vqxel/RezqMicromouse/Notes/MotionProfileLogic2-1.png

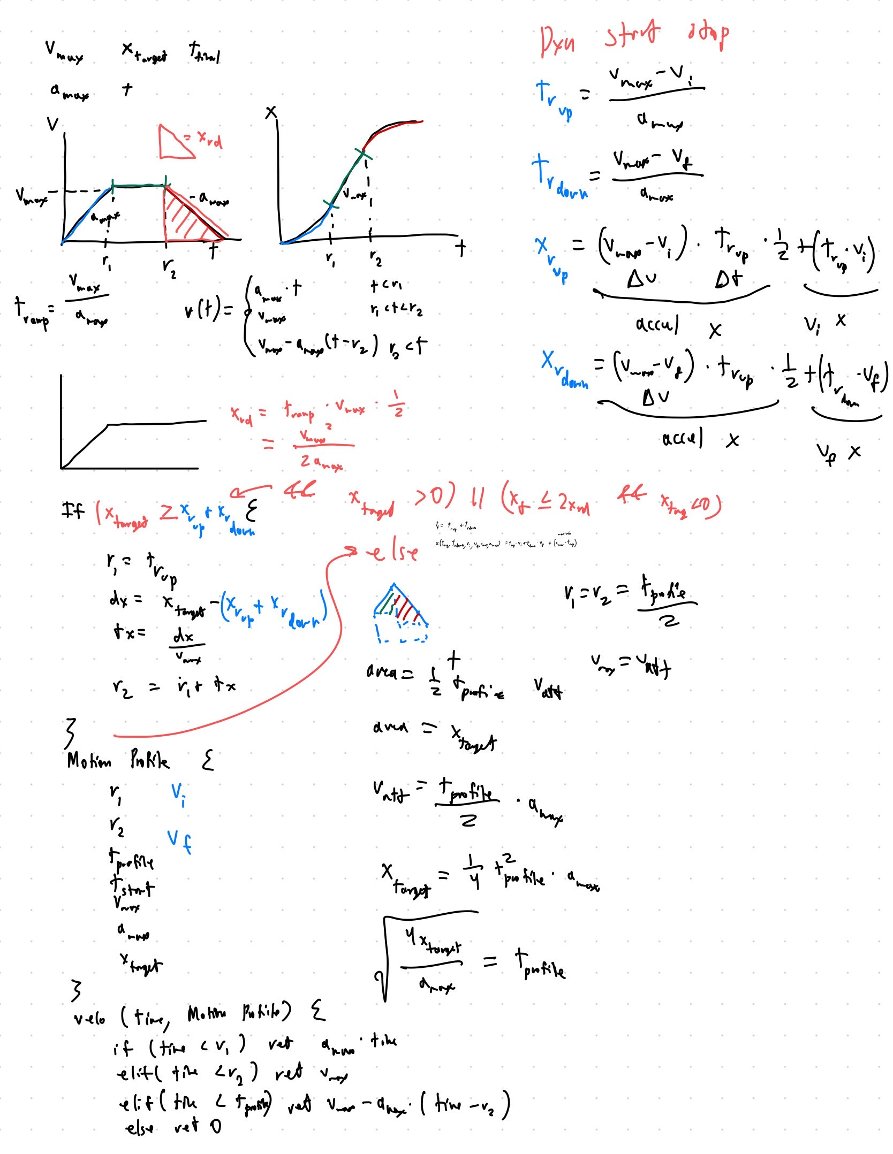
Notes/MotionProfileLogic2-1.png
