vqxel/RezqMicromouse/Notes/MotionProfileLogic2-2.png

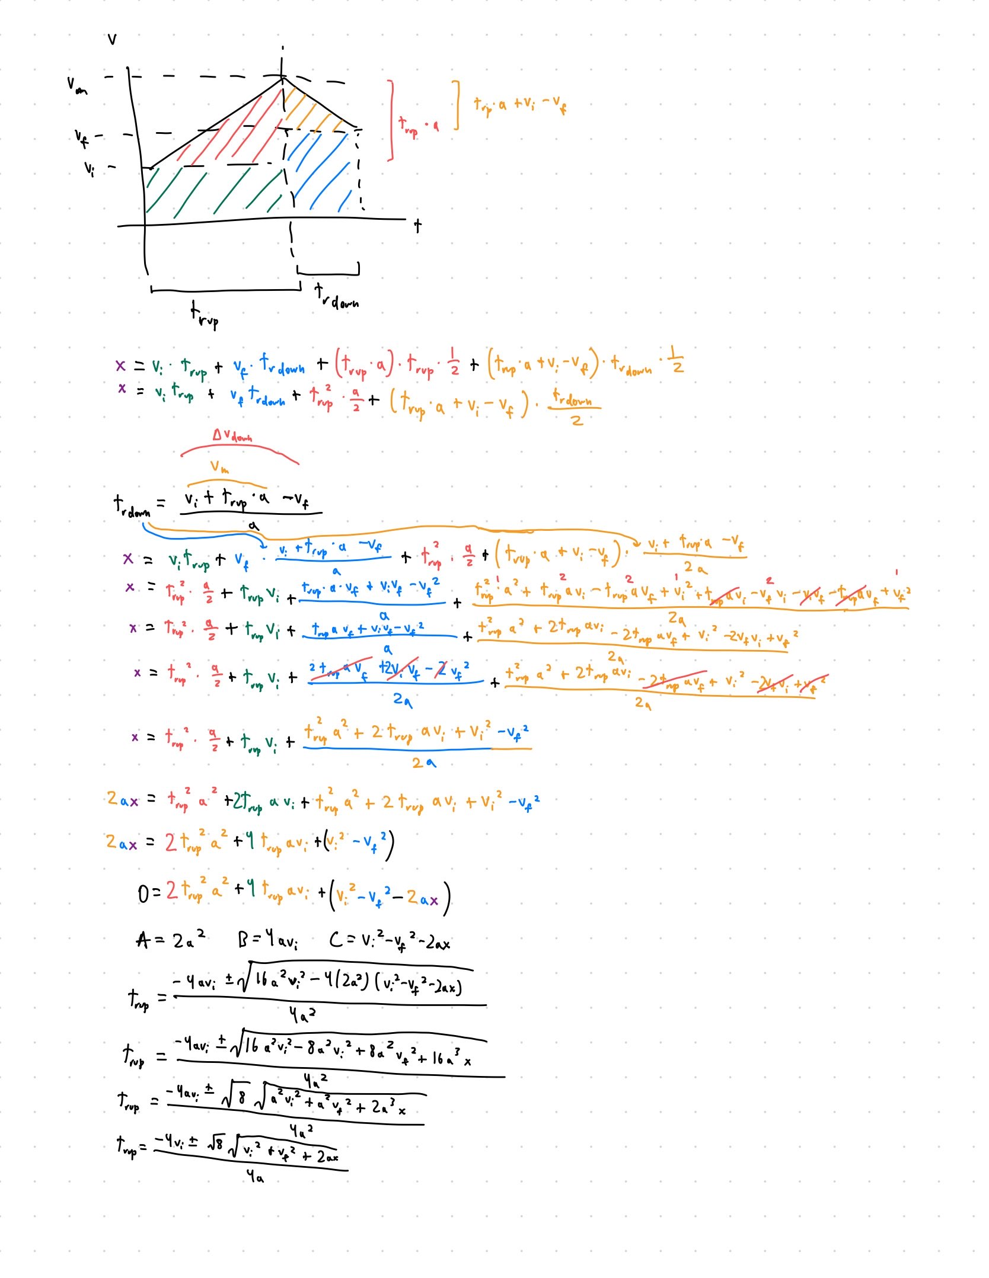
Notes/MotionProfileLogic2-2.png
