vqxel/RezqMicromouse/Notes/MotionProfileLogic.png

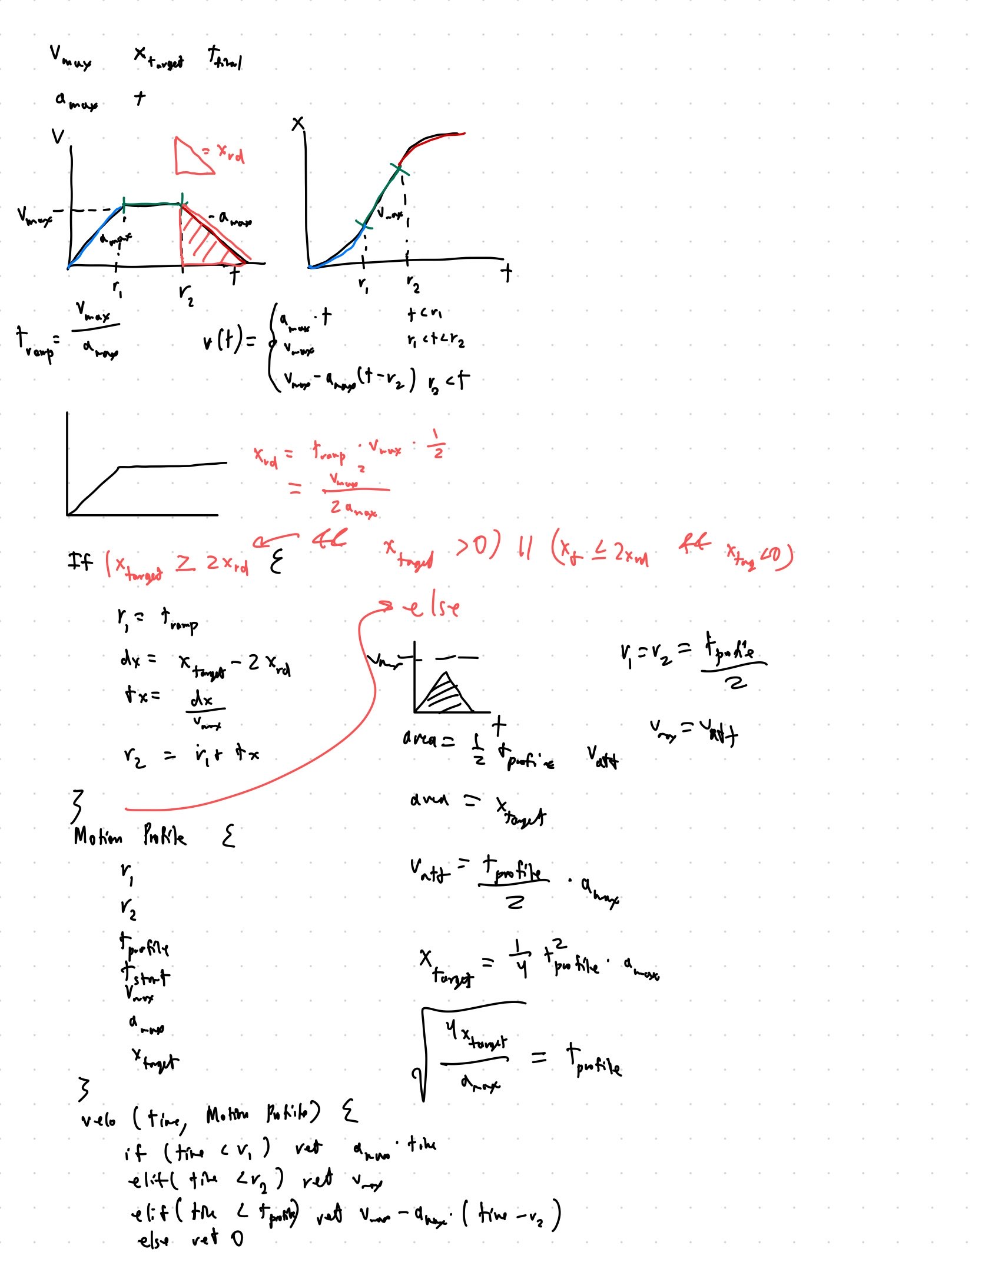
Notes/MotionProfileLogic.png
