vqxel/RezqMicromouse/Assets/VXL - ALTFX.dxf

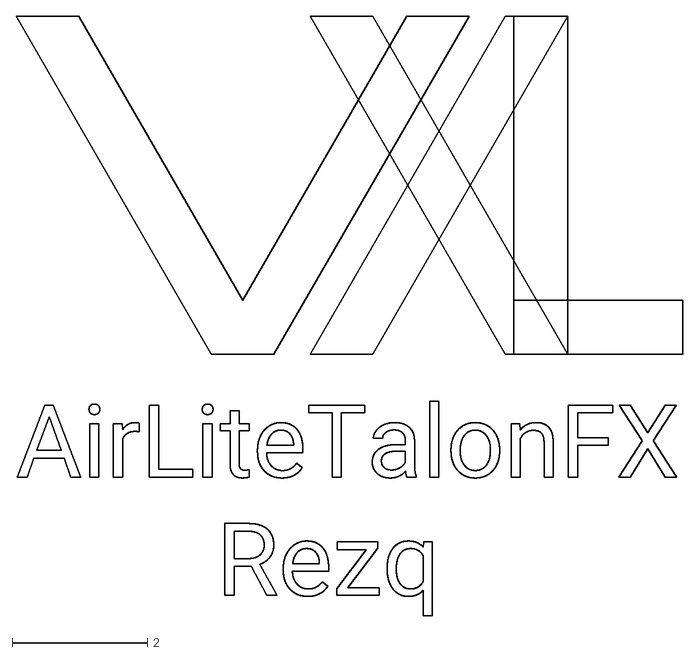
[picture p4: CAD file, 2024-12-14]
Assets/VXL - ALTFX.dxf
9.85 x 8.86
