vqxel/RezqMicromouse/EKFExperiments/ekf_test_result.png

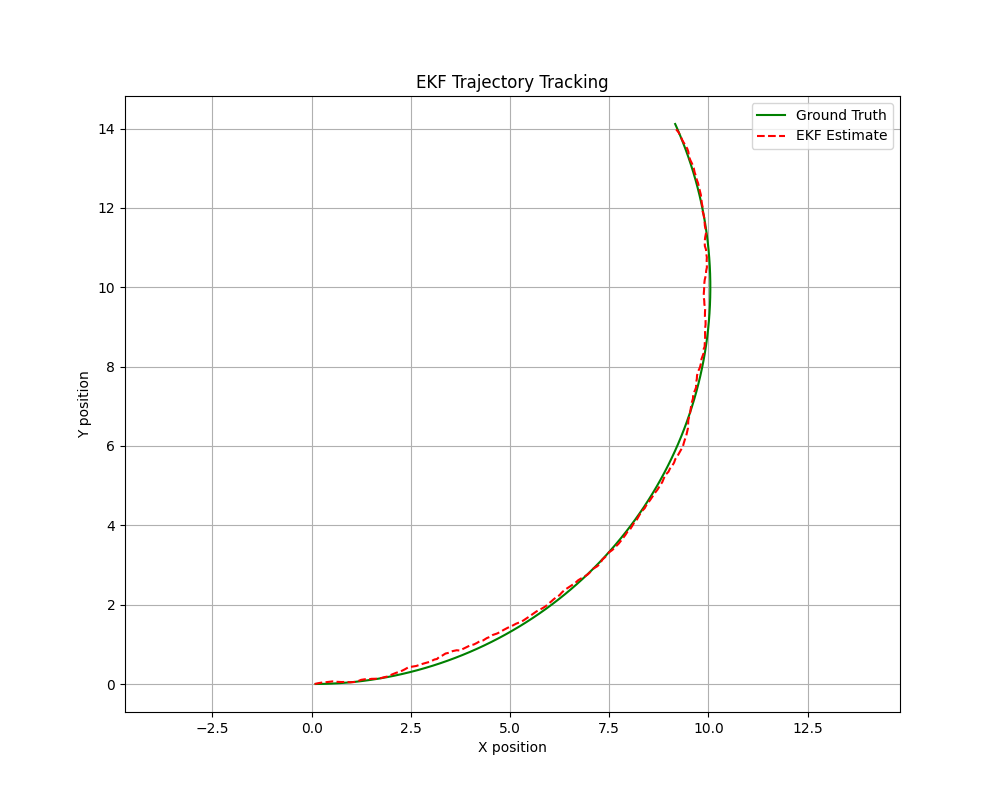
EKFExperiments/ekf_test_result.png
