vqxel/RezqMicromouse/CAD/mouse2_kicad_rev1/mouse2_rev1.kicad_pcb

## KiCad design CAD/mouse2_kicad_rev1/mouse2_rev1.kicad_pcb (2026-01-26)

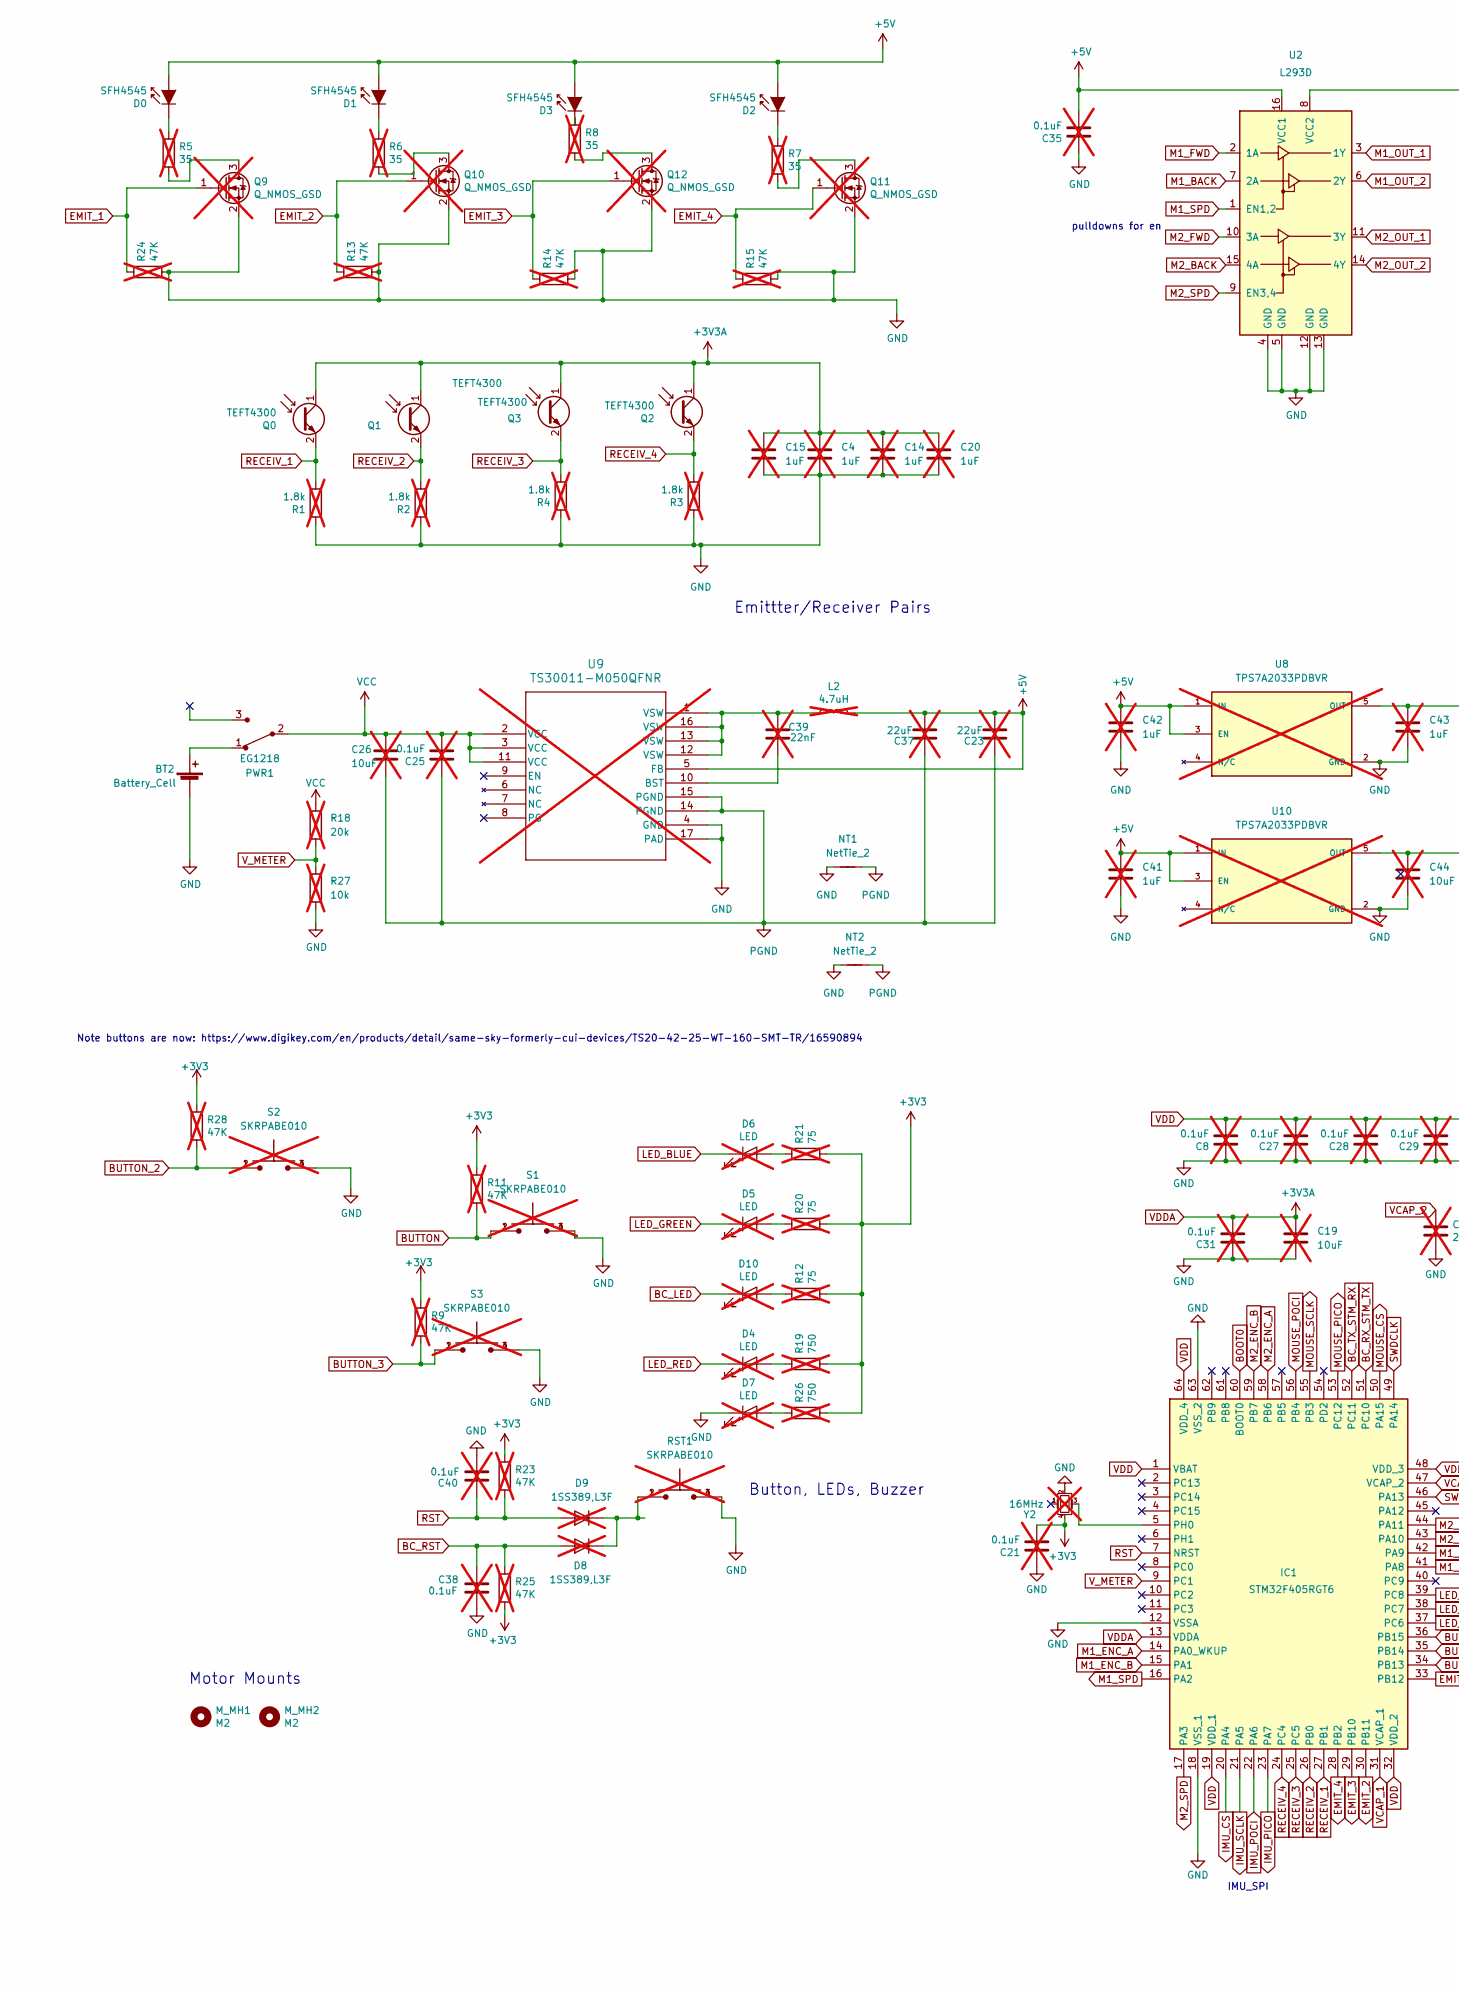
[picture p6: schematic mouse2_rev1.kicad_sch, part in row 1, column 1]

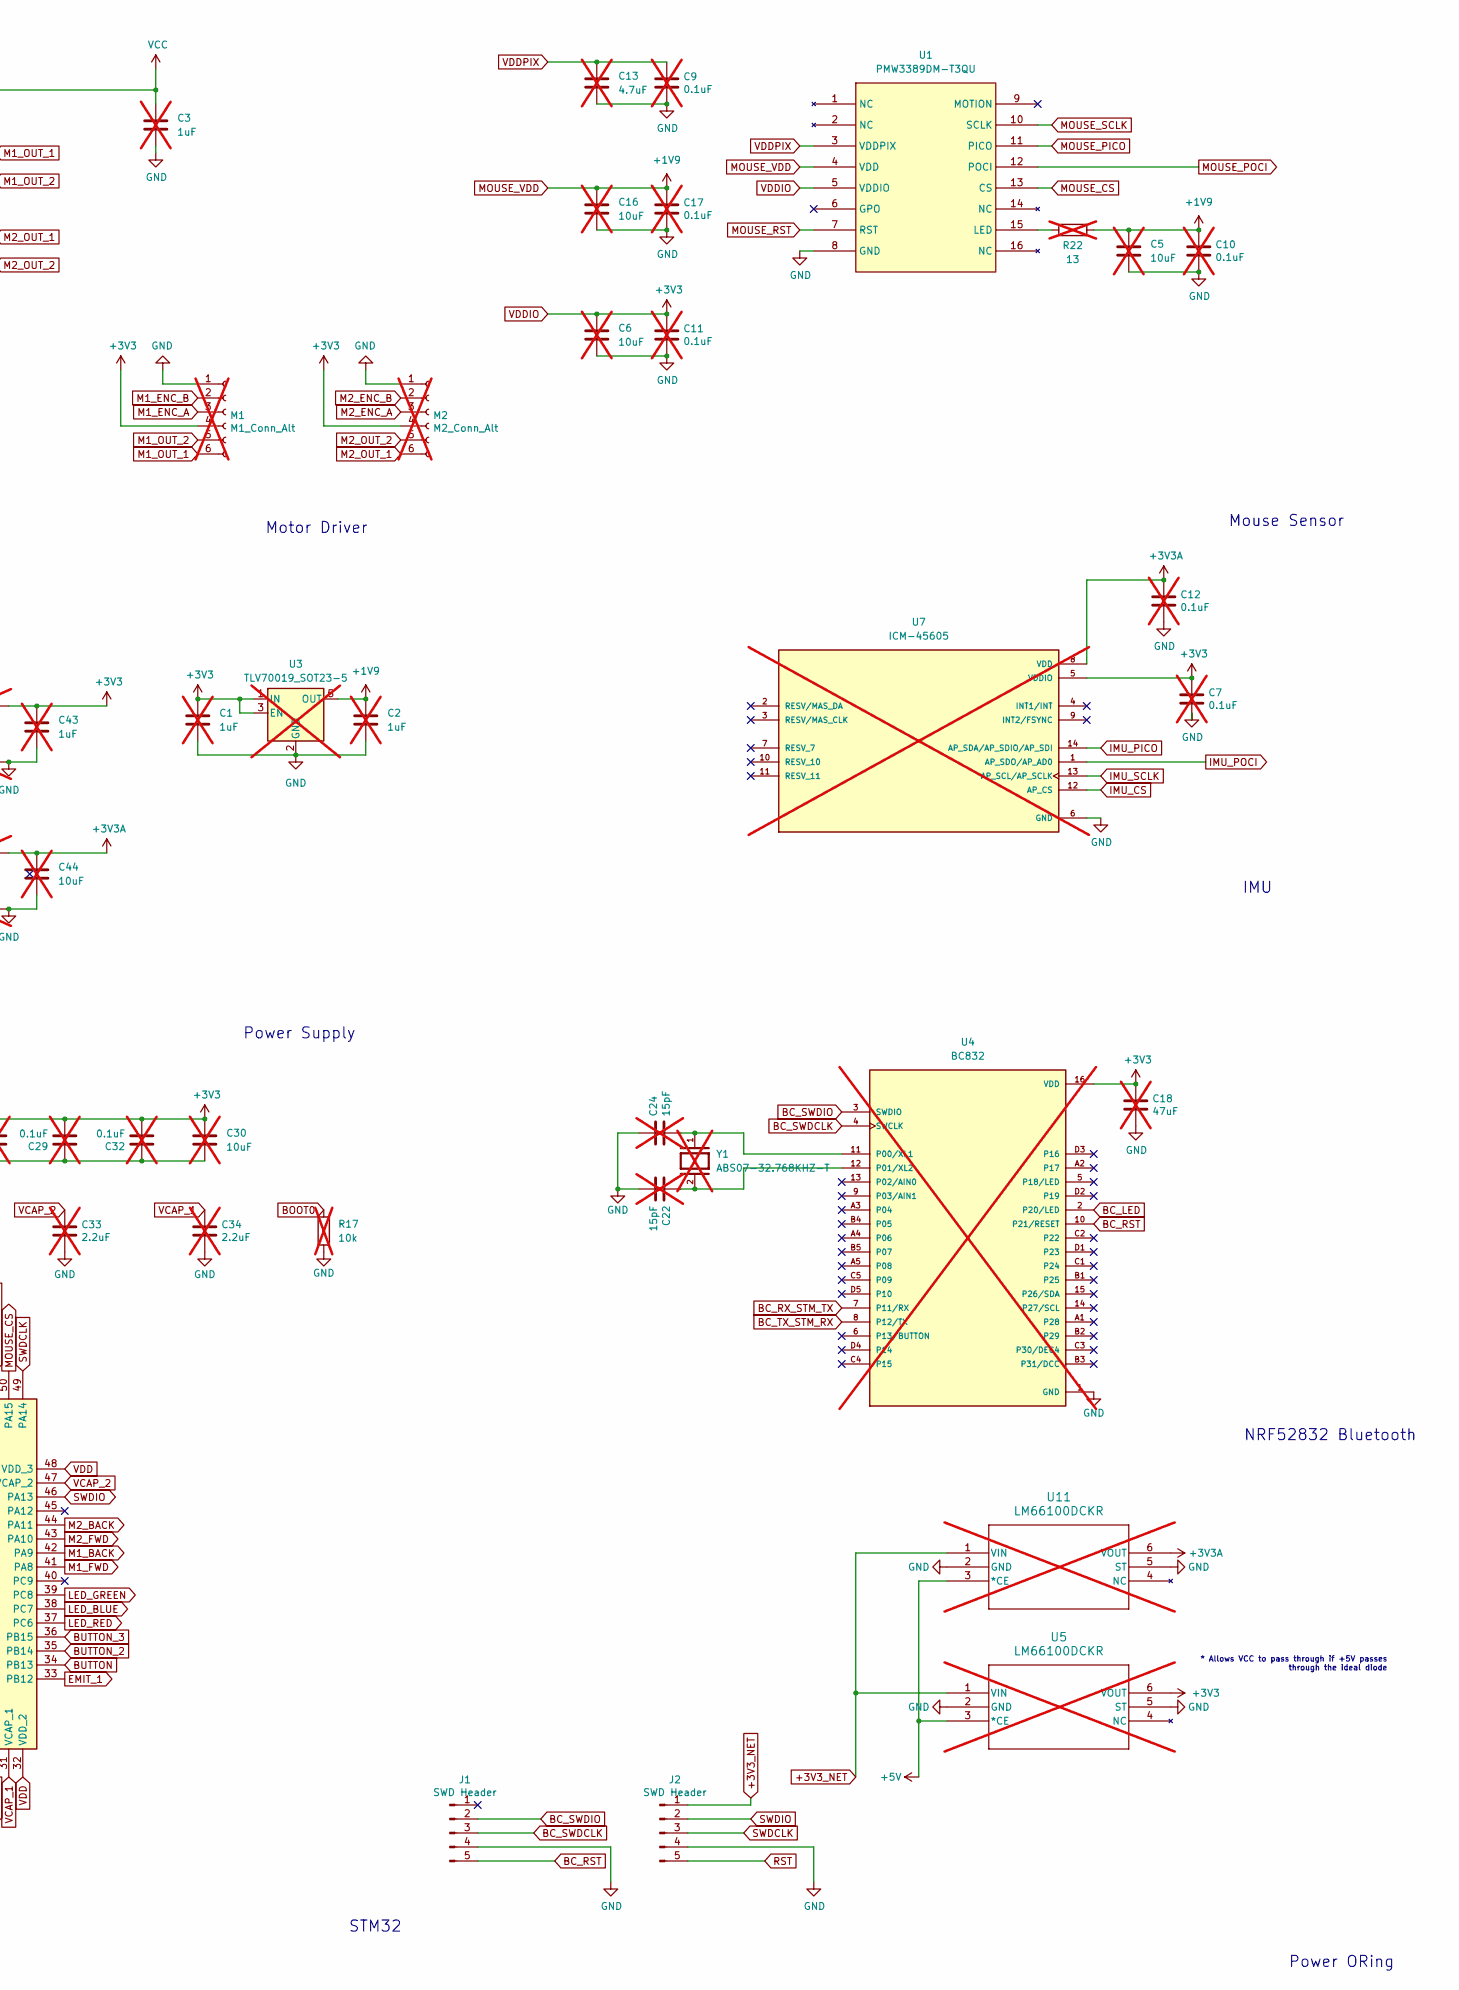
[picture p7: schematic mouse2_rev1.kicad_sch, part in row 1, column 2]

Parts:
BT2: Battery_Cell; PinSocket_1x02_P2.54mm_Vertical
C1, C2, C3, C4, C14, C15, C20, C41, C42, C43: 1uF; C_0603_1608Metric_Pad1.08x0.95mm_HandSolder; not fitted
C5, C6, C16, C19, C26, C30, C44: 10uF; C_0603_1608Metric_Pad1.08x0.95mm_HandSolder; not fitted
C7, C8, C9, C10, C11, C12, C17, C21, C25, C27, C28, C29, C31, C32, C35, C38, C40: 0.1uF; C_0603_1608Metric_Pad1.08x0.95mm_HandSolder; not fitted
C13: 4.7uF; C_0603_1608Metric_Pad1.08x0.95mm_HandSolder; not fitted
C18: 47uF; C_0603_1608Metric_Pad1.08x0.95mm_HandSolder; not fitted
C22, C24: 15pF; C_0603_1608Metric_Pad1.08x0.95mm_HandSolder; not fitted
C23, C37: 22uF; C_0603_1608Metric_Pad1.08x0.95mm_HandSolder; not fitted
C33, C34: 2.2uF; C_0603_1608Metric_Pad1.08x0.95mm_HandSolder; not fitted
C39: 22nF; C_0603_1608Metric_Pad1.08x0.95mm_HandSolder; not fitted
D0, D1, D2, D3: SFH4545; Emitter
D4, D5, D6, D7, D10: LED; LED_0805_2012Metric_Pad1.15x1.40mm_HandSolder; not fitted
D8, D9: 1SS389,L3F; D_SOD-523; not fitted
IC1: STM32F405RGT6; QFP50P1200X1200X160-64N; Manufacturer_Part_Number STM32F405RGT6; Mouser Part Number 511-STM32F405RGT6
J1, J2: SWD Header; PinHeader_1x05_P2.54mm_Vertical
L2: 4.7uH; L_1210_3225Metric_Pad1.42x2.65mm_HandSolder; not fitted
M1: M1_Conn_Alt; JST_SH_BM06B-SRSS-TB_1x06-1MP_P1.00mm_Vertical; not fitted
M2: M2_Conn_Alt; JST_SH_BM06B-SRSS-TB_1x06-1MP_P1.00mm_Vertical; not fitted
M_MH1, M_MH2: M2; Motor_mouse
NT1, NT2: NetTie_2; NetTie-2_SMD_Pad0.5mm
PWR1: EG1218; MM Switch; MPN EG1218; Digi-Key_PN EG1903-ND
Q0, Q1, Q2, Q3: TEFT4300; Emitter
Q9, Q10, Q11, Q12: Q_NMOS_GSD; SOT-23; not fitted
R1, R2, R3, R4: 1.8k; R_0603_1608Metric_Pad0.98x0.95mm_HandSolder; not fitted
R5, R6, R7, R8: 35; R_0603_1608Metric_Pad0.98x0.95mm_HandSolder; not fitted
R9, R11, R13, R14, R15, R23, R24, R25, R28: 47K; R_0603_1608Metric_Pad0.98x0.95mm_HandSolder; not fitted
R12, R20, R21: 75; R_0603_1608Metric_Pad0.98x0.95mm_HandSolder; not fitted
R17, R27: 10k; R_0603_1608Metric_Pad0.98x0.95mm_HandSolder; not fitted
R18: 20k; R_0603_1608Metric_Pad0.98x0.95mm_HandSolder; not fitted
R19, R26: 750; R_0603_1608Metric_Pad0.98x0.95mm_HandSolder; not fitted
R22: 13; R_0603_1608Metric_Pad0.98x0.95mm_HandSolder; not fitted
RST1: SKRPABE010; SW_SKRPABE010; not fitted
S1, S2, S3: SKRPABE010; SW_SKRPABE010; not fitted
U1: PMW3389DM-T3QU; PMW3360DM
U2: L293D; DIP-16_W7.62mm
U3: TLV70019_SOT23-5; SOT-23-5; not fitted
U4: BC832; XCVR_BC832; PARTREV 2.02; not fitted
U5, U11: LM66100DCKR; DCK6_TEX; not fitted
U7: ICM-45605; XDCR_ICM-45605; PARTREV 1.0; DigiKey_Part_Number 1428-ICM-45605CT-ND; not fitted
U8, U10: TPS7A2033PDBVR; SOT95P280X145-5N; PARTREV H; not fitted
U9: TS30011-M050QFNR; QFN16_3X3_SEM; not fitted
Y1: ABS07-32.768KHZ-T; XTAL_ABS07-32.768KHZ-T; PARTREV 08.19.15; not fitted
Y2: 16MHz; Crystal_SMD_2016-4Pin_2.0x1.6mm; Part # ECS-1633-160-BN-TR; not fitted

Connections:
+3V3_NET: J2.1, U5.1 (VIN), U11.1 (VIN)
+5V: C23.1, C35.2, C37.1, C41.1, C42.1, D0.2 (A), D1.2 (A), D2.2 (A), D3.2 (A), L2.2, U2.16 (VCC1), U5.3 (*CE), U8.1 (IN), U8.3 (EN), U9.5 (FB), U10.1 (IN), U10.3 (EN), U11.3 (*CE)
BC_LED: D10.1 (K), U4.2 (P20/LED)
BC_RST: C38.1, D8.2 (A), J1.5, R25.1, U4.10 (P21/RESET)
BC_RX_STM_TX: IC1.51 (PC10), U4.7 (P11/RX)
BC_SWDCLK: J1.3, U4.4 (SWCLK)
BC_SWDIO: J1.2, U4.3 (SWDIO)
BC_TX_STM_RX: IC1.52 (PC11), U4.8 (P12/TX)
BOOT0: IC1.60 (BOOT0), R17.1
BUTTON: IC1.34 (PB13), R11.2, S1.1, S1.2
BUTTON_2: IC1.35 (PB14), R28.2, S2.1, S2.2
BUTTON_3: IC1.36 (PB15), R9.2, S3.1, S3.2
EMIT_1: IC1.33 (PB12), Q9.1 (G), R24.1
EMIT_2: IC1.30 (PB11), Q10.1 (G), R13.1
EMIT_3: IC1.29 (PB10), Q12.1 (G), R14.1
EMIT_4: IC1.28 (PB2), Q11.1 (G), R15.1
GND: BT2.2 (-), C1.2, C2.2, C3.2, C4.2, C5.2, C6.2, C7.2, C8.1, C9.2, C10.2, C11.2, C12.2, C13.2, C14.2, C15.2, C16.2, C17.2, C18.2, C19.2, C20.2, C21.1, C22.2, C24.1, C27.1, C28.1, C29.1, C30.2, C31.1, C32.1, C33.2, C34.2, C35.1, C38.2, C40.2, C41.2, C42.2, C43.2, C44.2, D7.1 (K), IC1.12 (VSSA), IC1.18 (VSS_1), IC1.63 (VSS_2), J1.4, J2.4, M1.1, M2.1, NT1.1, NT2.1, Q9.2 (S), Q10.2 (S), Q11.2 (S), Q12.2 (S), R1.1, R2.1, R3.1, R4.1, R13.2, R14.2, R15.2, R17.2, R24.2, R27.2, RST1.3, RST1.4, S1.3, S1.4, S2.3, S2.4, S3.3, S3.4, U1.8 (GND), U2.4 (GND), U2.5 (GND), U2.12 (GND), U2.13 (GND), U3.2 (GND), U4.1 (GND), U5.2 (GND), U5.5 (ST), U7.6 (GND), U8.2 (GND), U9.4 (GND), U9.17 (PAD), U10.2 (GND), U11.2 (GND), U11.5 (ST), Y2.2
IMU_CS: IC1.20 (PA4), U7.12 (AP_CS)
IMU_PICO: IC1.23 (PA7), U7.14 (AP_SDA/AP_SDIO/AP_SDI)
IMU_POCI: IC1.22 (PA6), U7.1 (AP_SDO/AP_AD0)
IMU_SCLK: IC1.21 (PA5), U7.13 (AP_SCL/AP_SCLK)
LED_BLUE: D6.1 (K), IC1.38 (PC7)
LED_GREEN: D5.1 (K), IC1.39 (PC8)
LED_RED: D4.1 (K), IC1.37 (PC6)
M1_BACK: IC1.42 (PA9), U2.7 (2A)
M1_ENC_A: IC1.14 (PA0_WKUP), M1.3
M1_ENC_B: IC1.15 (PA1), M1.2
M1_FWD: IC1.41 (PA8), U2.2 (1A)
M1_OUT_1: M1.6, U2.3 (1Y)
M1_OUT_2: M1.5, U2.6 (2Y)
M1_SPD: IC1.16 (PA2), U2.1 (EN1,2)
M2_BACK: IC1.44 (PA11), U2.15 (4A)
M2_ENC_A: IC1.58 (PB6), M2.3
M2_ENC_B: IC1.59 (PB7), M2.2
M2_FWD: IC1.43 (PA10), U2.10 (3A)
M2_OUT_1: M2.6, U2.11 (3Y)
M2_OUT_2: M2.5, U2.14 (4Y)
M2_SPD: IC1.17 (PA3), U2.9 (EN3,4)
MOUSE_CS: IC1.50 (PA15), U1.13 (CS)
MOUSE_PICO: IC1.53 (PC12), U1.11 (PICO)
MOUSE_POCI: IC1.56 (PB4), U1.12 (POCI)
MOUSE_RST: U1.7 (RST)
MOUSE_SCLK: IC1.55 (PB3), U1.10 (SCLK)
MOUSE_VDD: C2.1, C5.1, C10.1, C16.1, C17.1, R22.2, U1.4 (VDD), U3.5 (OUT)
unnamed: BT2.1 (+), PWR1.1
unnamed: C39.2, L2.1, U9.1 (VSW), U9.12 (VSW), U9.13 (VSW), U9.16 (VSW)
unnamed: D0.1 (K), R5.1
unnamed: D1.1 (K), R6.1
unnamed: D2.1 (K), R7.1
unnamed: D3.1 (K), R8.1
unnamed: D4.2 (A), R19.1
unnamed: D5.2 (A), R20.1
unnamed: D6.2 (A), R21.1
unnamed: D7.2 (A), R26.1
unnamed: D8.1 (K), D9.1 (K), RST1.1, RST1.2
unnamed: D10.2 (A), R12.1
unnamed: IC1.5 (PH0), Y2.3
unnamed: Q9.3 (D), R5.2
unnamed: Q10.3 (D), R6.2
unnamed: Q11.3 (D), R7.2
unnamed: Q12.3 (D), R8.2
unnamed: R22.1, U1.15 (LED)
unnamed: C24.2, U4.11 (P00/XL1), Y1.1
unnamed: C22.1, U4.12 (P01/XL2), Y1.2
unnamed: C39.1, U9.10 (BST)
PGND: C23.2, C25.1, C26.2, C37.2, NT1.2, NT2.2, U9.14 (PGND), U9.15 (PGND)
RECEIV_1: IC1.27 (PB1), Q0.2 (E), R1.2
RECEIV_2: IC1.26 (PB0), Q1.2 (E), R2.2
RECEIV_3: IC1.25 (PC5), Q3.2 (E), R4.2
RECEIV_4: IC1.24 (PC4), Q2.2 (E), R3.2
RST: C40.1, D9.2 (A), IC1.7 (NRST), J2.5, R23.2
SWDCLK: IC1.49 (PA14), J2.3
SWDIO: IC1.46 (PA13), J2.2
VCAP_1: C34.1, IC1.31 (VCAP_1)
VCAP_2: C33.1, IC1.47 (VCAP_2)
VCC: C3.1, C25.2, C26.1, PWR1.2, R18.1, U2.8 (VCC2), U9.2 (VCC), U9.3 (VCC), U9.11 (VCC)
VDD: C1.1, C6.1, C7.1, C8.2, C11.1, C18.1, C21.2, C27.2, C28.2, C29.2, C30.1, C32.2, C43.1, IC1.1 (VBAT), IC1.19 (VDD_1), IC1.32 (VDD_2), IC1.48 (VDD_3), IC1.64 (VDD_4), M1.4, M2.4, R9.1, R11.1, R12.2, R19.2, R20.2, R21.2, R23.1, R25.2, R26.2, R28.1, U1.5 (VDDIO), U3.1 (IN), U3.3 (EN), U4.16 (VDD), U5.6 (VOUT), U7.5 (VDDIO), U8.5 (OUT), Y2.4
VDDA: C4.1, C12.1, C14.1, C15.1, C19.1, C20.1, C31.2, C44.1, IC1.13 (VDDA), Q0.1 (C), Q1.1 (C), Q2.1 (C), Q3.1 (C), U7.8 (VDD), U10.5 (OUT), U11.6 (VOUT)
VDDPIX: C9.1, C13.1, U1.3 (VDDPIX)
V_METER: IC1.9 (PC1), R18.2, R27.1

Notes on the sheet:
Mouse Sensor
IMU_SPI
Power ORing
STM32
pulldowns for en
Motor Driver
* Allows VCC to pass through if +5V passes through the ideal diode
Emittter/Receiver Pairs
NRF52832 Bluetooth
Note buttons are now: https://www.digikey.com/en/products/detail/same-sky-formerly-cui-devices/TS20-42-25-WT-160-SMT-TR/16590894
IMU
Motor Mounts
Button, LEDs, Buzzer
Power Supply

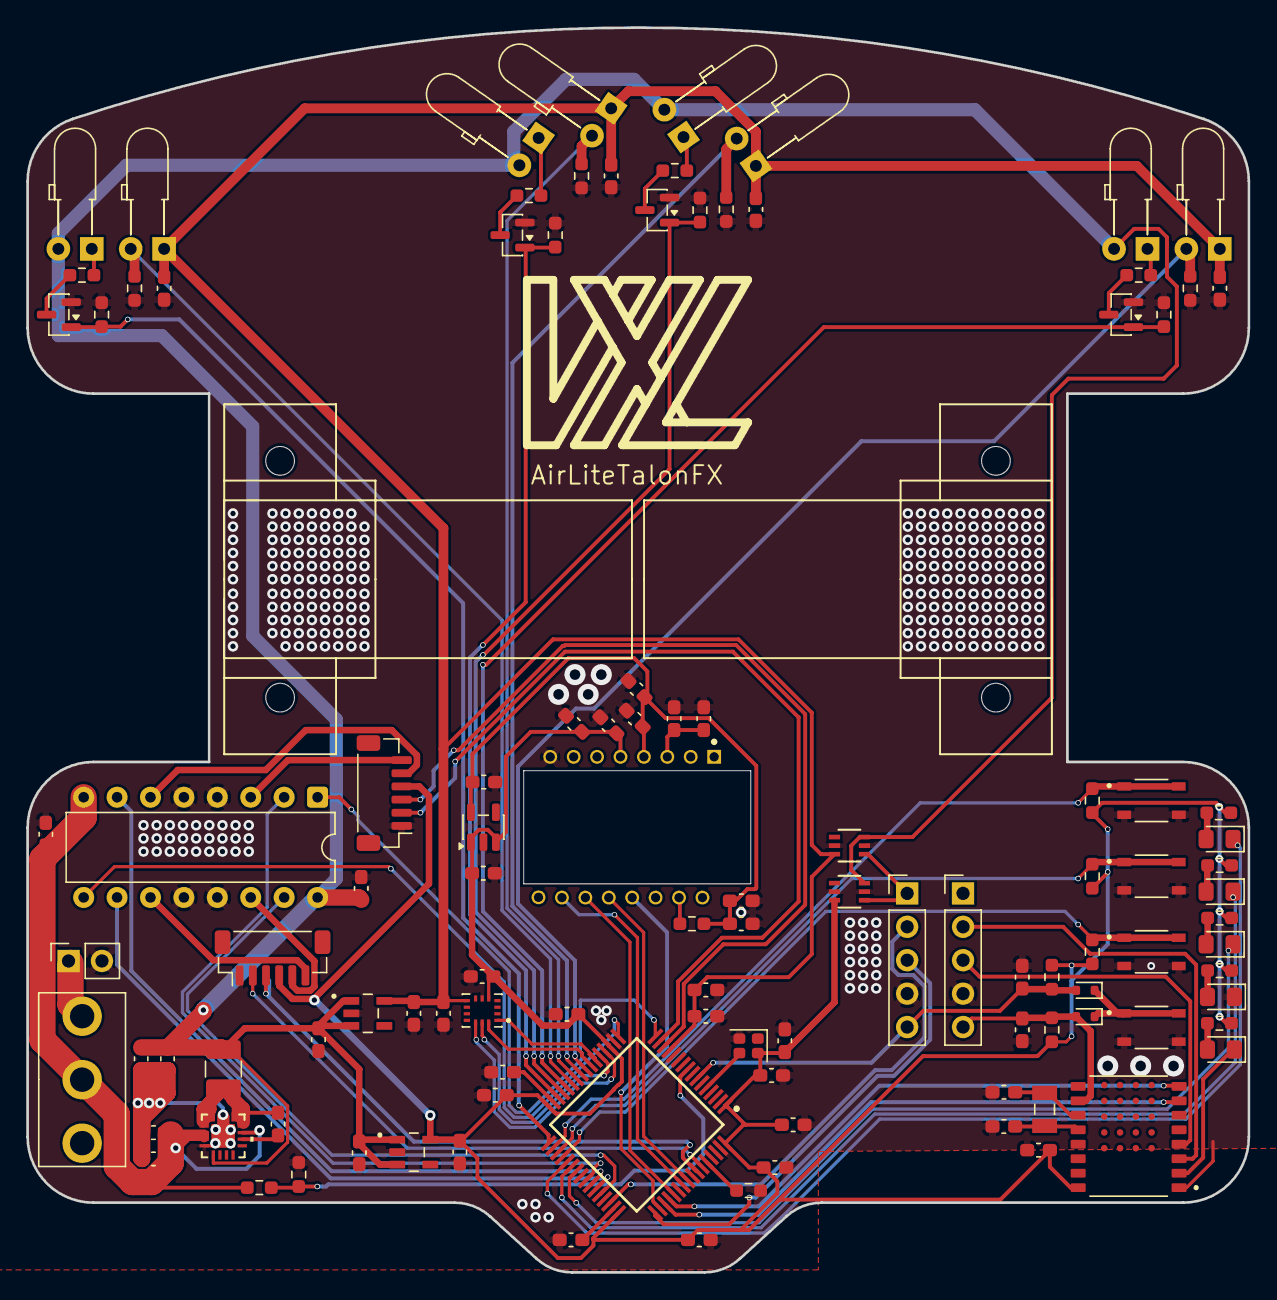
[picture p8: board mouse2_rev1.kicad_pcb from above]

Board: 2 copper layers, 92.8 x 94.6 mm, 116 parts (0 on the bottom side), 79 nets.
