vqxel/RezqMicromouse/AirLiteTalonFX2/Core/Src/main.c

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
/* Includes ------------------------------------------------------------------*/
#include "main.h"

/* USER CODE BEGIN Includes */
#include "stdbool.h"
#include "stdlib.h"
#include "string.h"
#include "arm_math.h"

#include "imu.h"
#include "mouse.h"
#include "motor.h"
#include "encoder.h"
#include "quaternion.h"
#include "ekf.h"
#include "stat_tracker.h"
#include "dsens.h"

/* USER CODE END Includes */

ADC_HandleTypeDef hadc1;

SPI_HandleTypeDef hspi1;
SPI_HandleTypeDef hspi3;

TIM_HandleTypeDef htim2;
TIM_HandleTypeDef htim4;
TIM_HandleTypeDef htim5;

UART_HandleTypeDef huart4;

void SystemClock_Config(void);
static void MX_GPIO_Init(void);
static void MX_ADC1_Init(void);
static void MX_SPI1_Init(void);
static void MX_TIM5_Init(void);
static void MX_SPI3_Init(void);
static void MX_TIM2_Init(void);
static void MX_TIM4_Init(void);
static void MX_UART4_Init(void);
/* USER CODE BEGIN PFP */
void CalibrateSensors(float32_t *gyroOffset, float32_t *R_gyro, float32_t *R_v, float32_t *R_w);
/* USER CODE END PFP */

/* USER CODE BEGIN 0 */

float32_t x_theta = 0;
float32_t y_theta = 0;
float32_t z_theta = 0;

float32_t R_gyro_yaw = 0.05f;
float32_t R_mouse_v = 0.2f;
float32_t R_mouse_w = 0.3f;

float32_t mouse_x_velo = 0;
float32_t mouse_omega = 0;
float32_t mouse_omega_deg = 0;
float32_t mouse_theta_est = 0;

float32_t rotation_quat[4] = {1, 0, 0, 0};

float32_t flDist = 0;
float32_t lDist = 0;
float32_t rDist = 0;
float32_t frDist = 0;

uint32_t last_button1_time = 0;
uint32_t last_button2_time = 0;
uint32_t last_button3_time = 0;
uint32_t debounce_delay = 50;

EKF stateFilter = {0};

Motor rightMotor = {0};
Motor leftMotor = {0};

Encoder rightEncoder = {0};
Encoder leftEncoder = {0};

DSens flSens = {0};
DSens lSens = {0};
DSens rSens = {0};
DSens frSens = {0};

volatile uint32_t us_multiplier;

void HAL_TIM_IC_CaptureCallback(TIM_HandleTypeDef *htim) {
	uint32_t currentCount = __HAL_TIM_GET_COUNTER(htim);
	Encoder_Callback(&leftEncoder, htim, currentCount);
	Encoder_Callback(&rightEncoder, htim, currentCount);
}

void HAL_GPIO_EXTI_Callback(uint16_t GPIO_Pin) {
	uint32_t current_tick = HAL_GetTick();
	if(GPIO_Pin == BUTTON_1_Pin && (current_tick - last_button1_time > debounce_delay)) {
		HAL_GPIO_TogglePin(LED_RED_GPIO_Port, LED_RED_Pin);
		last_button1_time = current_tick;
	} else if(GPIO_Pin == BUTTON_2_Pin && (current_tick - last_button2_time > debounce_delay)) {
		HAL_GPIO_TogglePin(LED_BLUE_GPIO_Port, LED_BLUE_Pin);
		last_button2_time = current_tick;
	} else if(GPIO_Pin == BUTTON_3_Pin && (current_tick - last_button3_time > debounce_delay)) {
		HAL_GPIO_TogglePin(LED_GREEN_GPIO_Port, LED_GREEN_Pin);
		last_button3_time = current_tick;
	}
}

// Call this function inside main() BEFORE using the mouse
void DWT_Init(void) {
    CoreDebug->DEMCR |= CoreDebug_DEMCR_TRCENA_Msk;
    DWT->CYCCNT = 0;
    DWT->CTRL |= DWT_CTRL_CYCCNTENA_Msk;

    // Use HAL_RCC_GetHCLKFreq() here to get the exact system logic freq
    uint32_t freq = HAL_RCC_GetHCLKFreq();

    // Calculate how many ticks are in 1 microsecond
    us_multiplier = freq / 1000000;
}

void delay_us(uint32_t us) {
    uint32_t startTick = DWT->CYCCNT;
    uint32_t ticksNeeded = us * us_multiplier;

    while ((DWT->CYCCNT - startTick) < ticksNeeded);
}


/* USER CODE END 0 */

/**
  * @brief  The application entry point.
  * @retval int
  */
int main(void)
{

  /* MCU Configuration--------------------------------------------------------*/

  /* Reset of all peripherals, Initializes the Flash interface and the Systick. */
  HAL_Init();

  /* Configure the system clock */
  SystemClock_Config();

  /* USER CODE BEGIN SysInit */

  // Enable CPU timer
  DWT_Init();

  /* USER CODE END SysInit */

  /* Initialize all configured peripherals */
  MX_GPIO_Init();
  MX_ADC1_Init();
  MX_SPI1_Init();
  MX_TIM5_Init();
  MX_SPI3_Init();
  MX_TIM2_Init();
  MX_TIM4_Init();
  MX_UART4_Init();
  /* USER CODE BEGIN 2 */

  bool mouse_connected = Mouse_Init(&hspi3);
  bool imu_connected = IMU_Init(&hspi1);

  float32_t gyroOffset[3];
  IMU_CalibrateGyro(&hspi1, gyroOffset);

  float32_t accelReadings[3];
  IMU_ReadAccel(&hspi1, accelReadings);
  IMU_GenGravQuat(rotation_quat, accelReadings);

  EKF_Init(&stateFilter, 0.8f);

  CalibrateSensors(gyroOffset, &R_gyro_yaw, &R_mouse_v, &R_mouse_w);

  stateFilter.process_noise_data[EKF_CalculateIndex(5, 0, 0)] = 1e-4f; // X position variance
  stateFilter.process_noise_data[EKF_CalculateIndex(5, 1, 1)] = 1e-4f; // Y position variance
  stateFilter.process_noise_data[EKF_CalculateIndex(5, 2, 2)] = 1e-4f; // Yaw variance
  stateFilter.process_noise_data[EKF_CalculateIndex(5, 3, 3)] = 1e-2f; // Linear Velocity variance
  stateFilter.process_noise_data[EKF_CalculateIndex(5, 4, 4)] = 1e-2f; // Angular Velocity variance

  stateFilter.measurement_noise_data[EKF_CalculateIndex(5, 0, 0)] = 0.1f;  // Left Encoder jitter
  stateFilter.measurement_noise_data[EKF_CalculateIndex(5, 1, 1)] = 0.1f;  // Right Encoder jitter
  stateFilter.measurement_noise_data[EKF_CalculateIndex(5, 2, 2)] = R_gyro_yaw;
  stateFilter.measurement_noise_data[EKF_CalculateIndex(5, 3, 3)] = R_mouse_v;
  stateFilter.measurement_noise_data[EKF_CalculateIndex(5, 4, 4)] = R_mouse_w;

  bool left_motor_initialized = Motor_Init(&rightMotor, M1_FWD_GPIO_Port, M1_BACK_GPIO_Port, M1_FWD_Pin, M1_BACK_Pin, &TIM5->CCR3, &htim5, TIM_CHANNEL_3, true);
  bool right_motor_initialized = Motor_Init(&leftMotor, M2_FWD_GPIO_Port, M2_BACK_GPIO_Port, M2_FWD_Pin, M2_BACK_Pin, &TIM5->CCR4, &htim5, TIM_CHANNEL_4, false);

  bool left_encoder_initialized = Encoder_Init(&rightEncoder, &htim2, true, 1.0f / 5968.31f);
  bool right_encoder_initialized = Encoder_Init(&leftEncoder, &htim4, false, 1.0f / 5968.31f);

  DSens_Init(&flSens, EMIT_1_GPIO_Port, EMIT_1_Pin, &hadc1, ADC_CHANNEL_9, 309608344.0f, -2.02718f);
  DSens_Init(&lSens, EMIT_2_GPIO_Port, EMIT_2_Pin, &hadc1, ADC_CHANNEL_8, 30089.7773f, -0.835766f);
  DSens_Init(&rSens, EMIT_3_GPIO_Port, EMIT_3_Pin, &hadc1, ADC_CHANNEL_15, 587887.835f, -1.21735f);
  DSens_Init(&frSens, EMIT_4_GPIO_Port, EMIT_4_Pin, &hadc1, ADC_CHANNEL_14, 1373374.48f, -1.32993f);

  if (!(mouse_connected && imu_connected && left_motor_initialized && right_motor_initialized && left_encoder_initialized && right_encoder_initialized)) {
	  // Something didn't initialize properly
	  for (int i = 0; i < 50; i++) {
		  HAL_GPIO_TogglePin(LED_RED_GPIO_Port, LED_RED_Pin);
		  HAL_Delay(100);
	  }
  }

  /* USER CODE END 2 */

  /* Infinite loop */
  /* USER CODE BEGIN WHILE */
  uint32_t tickTime = DWT->CYCCNT;
  while (1)
  {
    /* USER CODE END WHILE */

    /* USER CODE BEGIN 3 */

	  MouseData mouseData = {0};
	  Mouse_MotionRead(&hspi3, &mouseData);

	  float32_t gyroReadings[3];
	  float32_t accelReadings[3];

	  IMU_ReadGyroRadPerSec(&hspi1, gyroReadings);
	  IMU_ReadAccel(&hspi1, accelReadings);

	  uint32_t tickTimeNew = DWT->CYCCNT;
	  uint32_t delta = tickTimeNew - tickTime;
	  float32_t dt = (float32_t)delta / (float32_t)HAL_RCC_GetHCLKFreq();
	  tickTime = tickTimeNew;

	  // Gyro processing
	  IMU_ApplyGyroOffset(gyroReadings, gyroOffset);

	  IMU_GyroAccelMadgwickFilter(0.1, rotation_quat, gyroReadings, accelReadings, dt);

	  float32_t rotationEuler[3];
	  Quaternion_To_Euler_Deg(rotation_quat, rotationEuler);

	  x_theta = rotationEuler[0];
	  y_theta = rotationEuler[1];
	  z_theta = rotationEuler[2];


	  // Mouse processing
	  Mouse_GetVelocity(&mouseData, dt, &mouse_x_velo, &mouse_omega);
	  mouse_omega_deg = mouse_omega * 180 / PI;
	  mouse_theta_est += mouse_omega_deg * dt;

	  // Encoder processing
	  Encoder_Tick(&leftEncoder, dt);
	  Encoder_Tick(&rightEncoder, dt);

	  // Distance sensor processing
	  DSens_Update(&flSens);
	  DSens_Update(&lSens);
	  DSens_Update(&rSens);
	  DSens_Update(&frSens);

	  flDist = DSens_GetDist(&flSens);
	  lDist = DSens_GetDist(&lSens);
	  rDist = DSens_GetDist(&rSens);
	  frDist = DSens_GetDist(&frSens);

	  EKF_AddMeasurementAndUpdate(&stateFilter, leftEncoder.rawVeloMeters, rightEncoder.rawVeloMeters, z_theta, mouse_x_velo, mouse_omega, dt);

	  const float32_t kp = 1;
	  const float32_t error = 1 - EKF_GetPosX(&stateFilter);
	  Motor_Set(&leftMotor, kp * error);
	  Motor_Set(&rightMotor, kp * error);
  }
  /* USER CODE END 3 */
}

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
/* USER CODE BEGIN 4 */
void CalibrateSensors(float32_t *gyroOffset, float32_t *R_gyro, float32_t *R_v, float32_t *R_w) {
  StatTracker gyroStats = {0};
  StatTracker mouseVStats = {0};
  StatTracker mouseWStats = {0};

  uint32_t tickTime = DWT->CYCCNT;

  for (int i = 0; i < 1000; i++) {
	  float32_t g[3];
	  IMU_ReadGyroRadPerSec(&hspi1, g);
	  IMU_ApplyGyroOffset(g, gyroOffset);
	  StatTracker_Update(&gyroStats, g[2]);

	  MouseData mData = {0};
	  Mouse_MotionRead(&hspi3, &mData);

	  uint32_t tickTimeNew = DWT->CYCCNT;
	  uint32_t delta = tickTimeNew - tickTime;
	  float32_t dt = (float32_t)delta / (float32_t)HAL_RCC_GetHCLKFreq();
	  tickTime = tickTimeNew;

	  float32_t v, w;
	  Mouse_GetVelocity(&mData, dt, &v, &w);

	  StatTracker_Update(&mouseVStats, v);
	  StatTracker_Update(&mouseWStats, w);

	  HAL_Delay(2);
  }

  *R_gyro = StatTracker_GetVariance(&gyroStats);
  *R_v = StatTracker_GetVariance(&mouseVStats);
  *R_w = StatTracker_GetVariance(&mouseWStats);

  // Clamp to avoid zero variance
  if (*R_gyro < 1e-6f) *R_gyro = 1e-6f;
  if (*R_v < 1e-6f) *R_v = 1e-6f;
  if (*R_w < 1e-6f) *R_w = 1e-6f;
}
/* USER CODE END 4 */
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
