vqxel/RezqMicromouse/AirLiteTalonFX2/AirLiteTalonFX2.ioc

Mcu.UserName=STM32F405RGTx
PA0-WKUP.GPIO_Label=M1_ENC_A
PA0-WKUP.Signal=S_TIM2_CH1_ETR
PA1.GPIO_Label=M1_ENC_B
PA1.Signal=S_TIM2_CH2
PA10.GPIO_Label=M2_FWD
PA10.Signal=GPIO_Output
PA11.GPIO_Label=M2_BACK
PA11.Signal=GPIO_Output
PA13.Signal=SYS_JTMS-SWDIO
PA14.Signal=SYS_JTCK-SWCLK
PA15.GPIO_Label=MOUSE_CS
PA15.Signal=GPIO_Output
PA2.GPIO_Label=M1_SPD
PA2.Signal=S_TIM5_CH3
PA3.GPIO_Label=M2_SPD
PA3.Signal=S_TIM5_CH4
PA4.GPIO_Label=IMU_CS
PA4.Signal=GPIO_Output
PA5.GPIO_Label=IMU_SCLK
PA5.Signal=SPI1_SCK
PA6.GPIO_Label=IMU_POCI
PA6.Signal=SPI1_MISO
PA7.GPIO_Label=IMU_PICO
PA7.Signal=SPI1_MOSI
PA8.GPIO_Label=M1_FWD
PA8.Signal=GPIO_Output
PA9.GPIO_Label=M1_BACK
PA9.Signal=GPIO_Output
PB0.GPIO_Label=RECEIV_2
PB0.Signal=ADCx_IN8
PB1.GPIO_Label=RECEIV_1
PB1.Signal=ADCx_IN9
PB10.GPIO_Label=EMIT_3
PB10.Signal=GPIO_Output
PB11.GPIO_Label=EMIT_2
PB11.Signal=GPIO_Output
PB12.GPIO_Label=EMIT_1
PB12.Signal=GPIO_Output
PB13.GPIO_Label=BUTTON_1
PB13.Signal=GPIO_Input
PB14.GPIO_Label=BUTTON_2
PB14.Signal=GPIO_Input
PB15.GPIO_Label=BUTTON_3
PB15.Signal=GPIO_Input
PB2.GPIO_Label=EMIT_4
PB2.Signal=GPIO_Output
PB3.GPIO_Label=MOUSE_SCLK
PB3.Signal=SPI3_SCK
PB4.GPIO_Label=MOUSE_POCI
PB4.Signal=SPI3_MISO
PB6.GPIO_Label=M2_ENC_A
PB6.Signal=S_TIM4_CH1
PB7.GPIO_Label=M2_ENC_B
PB7.Signal=S_TIM4_CH2
PC1.GPIO_Label=V_METER
PC1.Signal=ADCx_IN11
PC10.GPIO_Label=BC_TX
PC10.Signal=UART4_TX
PC11.GPIO_Label=BC_RX
PC11.Signal=UART4_RX
PC12.GPIO_Label=MOUSE_PICO
PC12.Signal=SPI3_MOSI
PC4.GPIO_Label=RECEIV_4
PC4.Signal=ADCx_IN14
PC5.GPIO_Label=RECEIV_3
PC5.Signal=ADCx_IN15
PC6.GPIO_Label=LED_RED
PC6.Signal=GPIO_Output
PC7.GPIO_Label=LED_BLUE
PC7.Signal=GPIO_Output
PC8.GPIO_Label=LED_GREEN
PC8.Signal=GPIO_Output
PH0-OSC_IN.Signal=RCC_OSC_IN
PH1-OSC_OUT.Signal=RCC_OSC_OUT
