vqxel/RezqMicromouse/AirLiteTalonFX/Core/Src/main.cpp

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
/* Includes ------------------------------------------------------------------*/
#include "main.h"
#include "math.h"
#include "encoders.h"
#include "motor.h"
#include "vsens.h"
#include "dsens.h"
#include "motionprofile.h"
#include "PIDFF.h"
#include "differentialdrive.h"
#include "FloodFill.h"

ADC_HandleTypeDef hadc1;

TIM_HandleTypeDef htim2;
TIM_HandleTypeDef htim3;
TIM_HandleTypeDef htim4;

/* USER CODE BEGIN PV */
Encoder leftEncoder(&htim3, false, 0.151843644924);
Encoder rightEncoder(&htim4, false, 0.151843644924);
Motor leftMotor(M1_FWD_GPIO_Port, M1_BCK_GPIO_Port, M1_FWD_Pin, M1_BCK_Pin, &TIM2->CCR4, &htim2, TIM_CHANNEL_3, false);
Motor rightMotor(M2_FWD_GPIO_Port, M2_BCK_GPIO_Port, M2_FWD_Pin, M2_BCK_Pin, &TIM2->CCR3, &htim2, TIM_CHANNEL_4, true);
VSens vsens(&hadc1, ADC_CHANNEL_1);

DSens flSens(EMIT_1_GPIO_Port, EMIT_1_Pin, &hadc1, ADC_CHANNEL_9, FL_FACTOR, FL_POW);
DSens lSens(EMIT_2_GPIO_Port, EMIT_2_Pin, &hadc1, ADC_CHANNEL_8, L_FACTOR, L_POW);
DSens rSens(EMIT_3_GPIO_Port, EMIT_3_Pin, &hadc1, ADC_CHANNEL_5, R_FACTOR, R_POW);
DSens frSens(EMIT_4_GPIO_Port, EMIT_4_Pin, &hadc1, ADC_CHANNEL_4, FR_FACTOR, FR_POW);

PIDFF centeringPID(0.005, 0, 0, 0);

PIDFF leftPIDFF(0.003, 0, LEFT_KV, LEFT_KS);
PIDFF rightPIDFF(0.003, 0, RIGHT_KV, RIGHT_KS);

DifferentialDrive diffy(50);

/* USER CODE END PV */

void SystemClock_Config(void);
static void MX_GPIO_Init(void);
static void MX_ADC1_Init(void);
static void MX_TIM4_Init(void);
static void MX_TIM3_Init(void);
static void MX_TIM2_Init(void);
/* USER CODE BEGIN 0 */

void HAL_TIM_IC_CaptureCallback(TIM_HandleTypeDef *htim) {
	uint32_t currentCount = __HAL_TIM_GET_COUNTER(htim);
	leftEncoder.callback(htim, currentCount);
	rightEncoder.callback(htim, currentCount);
}

uint32_t lastTick = 0;
uint32_t curTick = 0;
uint32_t rawStartTick = 0;
uint32_t rawCurTick = 0;
uint32_t dt = 0;

float lastTheta = 0;
float theta = 0;

//float spedL[1000];
//float spedR[1000];
uint64_t ticks = 0;


MotionProfileState nextState = {0};

typedef enum {
	STOP,
	DFORWARD,
	DLEFT,
	DRIGHT,
	DSFORWARD,
	DUTURN
} Action;

typedef struct {
	float velo;
	float thetaVelo;
	bool complete;
	bool useWallCorrection;
} DiffyState;

typedef struct {
    int x = 0;
    int y = 0;
} Position;

bool forwardOneBoxInit = true;
float forwardOneBoxLPos = 0;
float forwardOneBoxRPos = 0;

MapNode race_map[MAP_SIZE][MAP_SIZE];

Position last_position = Position();
Position position =  Position();
Orientation orientation = NORTH;

DiffyState forwardOneBox(uint32_t dt) {
	if (forwardOneBoxInit) {
		forwardOneBoxLPos = leftEncoder.getPositionMeters();
		forwardOneBoxRPos = rightEncoder.getPositionMeters();

		last_position = position;

		switch (orientation) {
			case NORTH:
				position.y++;
				break;
			case EAST:
				position.x++;
				break;
			case SOUTH:
				position.y--;
				break;
			case WEST:
				position.x--;
				break;
		}

	}
	forwardOneBoxInit = false;

	DiffyState state = {0};
	state.useWallCorrection = true;
	float avgPosMeters = ((leftEncoder.getPositionMeters() - forwardOneBoxLPos) + (rightEncoder.getPositionMeters() - forwardOneBoxRPos)) / 2;
	MotionProfileState currentState = {avgPosMeters, (leftEncoder.getVeloMeters() + rightEncoder.getVeloMeters()) / 2, };
	MotionProfileState goalState = {180, 0};
	MotionProfileState nextState =  calculate_next_state(dt * 0.001, currentState, goalState, {200, 700});

	state.velo = nextState.velocity;

//	if (nextState.velocity <= 10) { /* abs(nextState.position - avgPosMeters) < 10 &&  */
//		state.complete = true;
//	}

	state.complete = is_finished(currentState, goalState, 30);

	return state;
}

Orientation rotate_orientation_left(Orientation orientation) {
    if (orientation == NORTH) {
        orientation = WEST;
        return orientation;
    }

    orientation = static_cast<Orientation>(orientation - 1);

    return orientation;
}

Orientation rotate_orientation_right(Orientation orientation) {
    if (orientation == WEST) {
        orientation = NORTH;
        return orientation;
    }

    orientation = static_cast<Orientation>(orientation + 1);

    return orientation;
}


bool rotateInit = true;
DiffyState rotate(uint32_t dt, bool left) {
	if (rotateInit) {
		// On init rotate the rotation state
		if (left) {
			orientation = rotate_orientation_left(orientation);
		} else {
			orientation = rotate_orientation_right(orientation);
		}
	}


	DiffyState state = {0};
	state.useWallCorrection = false;
	MotionProfileState currentState;
	  if (!rotateInit) {
		  currentState = {nextState.position, nextState.velocity};
	  } else {
		  currentState = {0, 0};
	  }
		rotateInit = false;
		MotionProfileState goalState = {(left ? -1 : 1) * 3.141592/2, 0};
	  nextState = calculate_next_state(dt * 0.001, currentState, goalState, {3.141592, 3.141592*4});

	state.thetaVelo = nextState.velocity;

	/*if (nextState.velocity <= 0.3141592) {
		state.complete = true;
	}*/

	state.complete = is_finished(currentState, goalState, 3.141592 / 8);


	return state;
}


bool rotate2Init = true;
DiffyState rotate2(uint32_t dt) {

	DiffyState state = {0};
	state.useWallCorrection = false;
	MotionProfileState currentState;
	  if (!rotateInit) {
		  currentState = {nextState.position, nextState.velocity};
	  } else {
		  currentState = {0, 0};
	  }
		rotateInit = false;
		MotionProfileState goalState = {3.141592, 0};
	  nextState = calculate_next_state(dt * 0.001, currentState, goalState, {3.141592, 3.141592*4});

	state.thetaVelo = nextState.velocity;

	/*if (nextState.velocity <= 0.3141592) {
		state.complete = true;
	}*/

	state.complete = is_finished(currentState, goalState, 3.141592 / 8);


	return state;
}

Action actionState = DSFORWARD;
Action enqueuedAction = DUTURN;

/* USER CODE END 0 */

/**
  * @brief  The application entry point.
  * @retval int
  */
int main(void)
{

  /* MCU Configuration--------------------------------------------------------*/

  /* Reset of all peripherals, Initializes the Flash interface and the Systick. */
  HAL_Init();

  /* Configure the system clock */
  SystemClock_Config();

  /* Initialize all configured peripherals */
  MX_GPIO_Init();
  MX_ADC1_Init();
  MX_TIM4_Init();
  MX_TIM3_Init();
  MX_TIM2_Init();
  /* USER CODE BEGIN 2 */
  HAL_TIM_Base_Start(&htim2);

  //altfx_init();
  HAL_Delay(2000);

  // Initial floodfill logic
  generate_map(race_map);
  propogate_race_distances(race_map);


  rawStartTick = HAL_GetTick();

  leftEncoder.init();
  rightEncoder.init();


  leftMotor.init();
  rightMotor.init();

  leftMotor.brakeMode = false;
  rightMotor.brakeMode = false;

  leftMotor.set(0);
  rightMotor.set(0);

  vsens.init();
  while (!vsens.poll());
  vsens.getVolts();

  /* USER CODE END 2 */

  /* Infinite loop */
  /* USER CODE BEGIN WHILE */

  //MotionProfile profile = generate_profile(200, 700, 180, 0, 0);

  bool init = true;
  lastTick = 0;
  while (1) {
	  if (init) {
		  lastTick = HAL_GetTick() - rawStartTick;
	  }

	  flSens.updateSens();
	  flSens.getDist();
	  lSens.updateSens();
	  lSens.getDist();
	  rSens.updateSens();
	  rSens.getDist();
	  frSens.updateSens();
	  frSens.getDist();
	  vsens.poll();
	  vsens.getVolts();
	  vsens.getCompMult();


	  leftEncoder.tick();
	  rightEncoder.tick();
	  rawCurTick = HAL_GetTick();
	  curTick = rawCurTick - rawStartTick;
	  uint32_t dt = curTick - lastTick;

	  float leftDelta = leftEncoder.getPositionMeters() - leftEncoder.getLastPositionMeters();
	  float rightDelta = rightEncoder.getPositionMeters() - rightEncoder.getLastPositionMeters();

	  float dTheta = (rightDelta - leftDelta) / diffy._rad;
	  theta += dTheta;


//	  HAL_GPIO_TogglePin(POWER_LED_GPIO_Port, POWER_LED_Pin);

	  //float v = profile_velo_wrt_t(rawCurTick * 0.001, startTime * 0.001, profile);


	 /* MotionProfileState currentState;
	  if (!init) {
		  currentState = {nextState.position, nextState.velocity};
	  } else {
		  currentState = {0, 0};
	  }
	  nextState = calculate_next_state(dt * 0.001, currentState, {3.141592 * 2, 0}, {3.141592, 3.141592*4});*/
//	  DiffyState targetState;
//	  if (actionState == DSFORWARD) {
//		  targetState = {500, 0, false, true};
//		  if (flSens.getDist() <= FL_THRESH && frSens.getDist() <= FR_THRESH) {
//				targetState.complete = true;
//		  }
//		  enqueuedAction = DUTURN;
//	  }
//	  else if (actionState == DUTURN) {
//		  targetState = rotate2(dt);
//		  enqueuedAction = DSFORWARD;
//	  }
//	  else if (actionState == DFORWARD) {
//		  targetState = forwardOneBox(dt);
//		  enqueuedAction = STOP;
//	  } else if (actionState == DLEFT) {
//		  targetState = rotate(dt, true);
//		  enqueuedAction = DFORWARD;
//	  } else if (actionState == DRIGHT) {
//		  targetState = rotate(dt, false);
//		  enqueuedAction = DFORWARD;
//	  } else if (actionState == STOP) {
//		  //targetState = {0, 0, true, true};
//		  if (lSens.getDist() <= LEFT_THRESH) {
//	            Orientation rotated_orientation = rotate_orientation_left(orientation);
//	            sever_path(&race_map[position.x][position.y], rotated_orientation);
//		  }
//
//		  if (rSens.getDist() <= RIGHT_THRESH) {
//	            Orientation rotated_orientation = rotate_orientation_right(orientation);
//	            sever_path(&race_map[position.x][position.y], rotated_orientation);
//		  }
//
//
//		  if (flSens.getDist() <= FL_THRESH && frSens.getDist() <= FR_THRESH) {
//	            sever_path(&race_map[position.x][position.y], orientation);
//		  }
//
//
//	        map_node(&race_map[position.x][position.y]);
//
//	        /*if (race_map[position.x][position.y].distance == 0) {
//				state = REHOMING;
//				break;
//			}*/
//
//	        Orientation target_dir = get_most_optimal_node_connection(&race_map[position.x][position.y], true, false).connection_orientation;
//		   int delta_theta = orientation - target_dir; // + means turn left | - means turn right
//
//		   if (abs(delta_theta) > 2) delta_theta = signbit(delta_theta) ? 1 : -1;
//
//		   if (delta_theta == 1) {
//			   actionState = DLEFT;
//		   } else if (delta_theta == -1) {
//			   actionState = DRIGHT;
//		   } else {
//			   actionState = DFORWARD;
//		   }
//
//	  }
//
//	  if (targetState.complete) {
//		  actionState = enqueuedAction;
//		  enqueuedAction = STOP;
//		  rotateInit = true;
//		  forwardOneBoxInit = true;
//	  }
//	  DiffyState targetState = {300, 0, false};



	  //DifferentialDrive::WheelSpeeds speeds = diffy.drive(newState.velocity, centeringPID.calculate(0, rSens.getDist() - lSens.getDist()));
	  /*DifferentialDrive::WheelSpeeds speeds = diffy.drive(targetState.velo, targetState.thetaVelo + ((targetState.useWallCorrection ? 1 : 0) * (centeringPID.calculate(0, rSens.getDist() - lSens.getDist())))); // 3.141592 * 2

	  leftMotor.set(leftPIDFF.calculate(speeds.lv, leftEncoder.getVeloMeters()) * vsens.getCompMult());
	  rightMotor.set(rightPIDFF.calculate(speeds.rv, rightEncoder.getVeloMeters()) * vsens.getCompMult());
*/
//	  leftMotor.set(leftPIDFF.calculate(0, leftEncoder.getVeloMeters()) * vsens.getCompMult());
//	  rightMotor.set(rightPIDFF.calculate(0, rightEncoder.getVeloMeters()) * vsens.getCompMult());
	  leftMotor.set(0);
	  rightMotor.set(0);
	  lastTick = curTick;
	  lastTheta = theta;
	  init = false;

  /*leftMotor.set(0);
  rightMotor.set(0); //\frac{1}{50\cdot12}\cdot2\pi\cdot\frac{29}{2}

  while (1)
  {
	  leftEncoder.tick();
	  rightEncoder.tick();
	  rawCurTick = HAL_GetTick();
	  curTick = rawCurTick - rawStartTick;

	  DifferentialDrive::WheelSpeeds speeds = diffy.drive(0, 2 * 3.14159264);

	  leftMotor.set(leftPIDFF.calculate(speeds.lv, leftEncoder.getVeloMeters()) * vsens.getCompMult());
	  rightMotor.set(rightPIDFF.calculate(speeds.rv, rightEncoder.getVeloMeters()) * vsens.getCompMult());*/
	  /*leftMotor.set(0.1);
	  rightMotor.set(0.1);

	  if (curTick > 2000 && curTick <= 4000) {
		  leftMotor.set(0.2);
		  rightMotor.set(0.2);
	  } else if (curTick > 4000 && curTick <= 6000) {
		  leftMotor.set(0.3);
		  rightMotor.set(0.3);
	  } else if (curTick > 6000 && curTick <= 8000) {
		  leftMotor.set(0.4);
		  rightMotor.set(0.4);
	  } else if (curTick > 8000 && curTick <= 10000) {
		  leftMotor.set(0.5);
		  rightMotor.set(0.5);
	  } else if (curTick > 10000 && curTick <= 12000) {
		  leftMotor.set(0.6);
		  rightMotor.set(0.6);
	  } else if (curTick > 12000 && curTick <= 14000) {
		  leftMotor.set(0.7);
		  rightMotor.set(0.7);
	  } else if (curTick > 14000) {
		  leftMotor.set(0);
		  rightMotor.set(0);
		  leftEncoder.getPositionMeters();
	  }*/

//	  spedL[ticks] = leftEncoder.getVeloMeters();
//	  spedR[ticks] = rightEncoder.getVeloMeters();
	  ticks++;

	  dt = curTick - lastTick;

	//altfx_loop();
    /* USER CODE END WHILE */

    /* USER CODE BEGIN 3 */
  }
  /* USER CODE END 3 */
}

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
