vqxel/RezqMicromouse/AirLiteTalonFX2/Core/Inc/main.h

#define V_METER_Pin GPIO_PIN_1
#define V_METER_GPIO_Port GPIOC
#define M1_ENC_A_Pin GPIO_PIN_0
#define M1_ENC_A_GPIO_Port GPIOA
#define M1_ENC_B_Pin GPIO_PIN_1
#define M1_ENC_B_GPIO_Port GPIOA
#define M1_SPD_Pin GPIO_PIN_2
#define M1_SPD_GPIO_Port GPIOA
#define M2_SPD_Pin GPIO_PIN_3
#define M2_SPD_GPIO_Port GPIOA
#define IMU_CS_Pin GPIO_PIN_4
#define IMU_CS_GPIO_Port GPIOA
#define IMU_SCLK_Pin GPIO_PIN_5
#define IMU_SCLK_GPIO_Port GPIOA
#define IMU_POCI_Pin GPIO_PIN_6
#define IMU_POCI_GPIO_Port GPIOA
#define IMU_PICO_Pin GPIO_PIN_7
#define IMU_PICO_GPIO_Port GPIOA
#define RECEIV_4_Pin GPIO_PIN_4
#define RECEIV_4_GPIO_Port GPIOC
#define RECEIV_3_Pin GPIO_PIN_5
#define RECEIV_3_GPIO_Port GPIOC
#define RECEIV_2_Pin GPIO_PIN_0
#define RECEIV_2_GPIO_Port GPIOB
#define RECEIV_1_Pin GPIO_PIN_1
#define RECEIV_1_GPIO_Port GPIOB
#define EMIT_4_Pin GPIO_PIN_2
#define EMIT_4_GPIO_Port GPIOB
#define EMIT_3_Pin GPIO_PIN_10
#define EMIT_3_GPIO_Port GPIOB
#define EMIT_2_Pin GPIO_PIN_11
#define EMIT_2_GPIO_Port GPIOB
#define EMIT_1_Pin GPIO_PIN_12
#define EMIT_1_GPIO_Port GPIOB
#define BUTTON_1_Pin GPIO_PIN_13
#define BUTTON_1_GPIO_Port GPIOB
#define BUTTON_1_EXTI_IRQn EXTI15_10_IRQn
#define BUTTON_2_Pin GPIO_PIN_14
#define BUTTON_2_GPIO_Port GPIOB
#define BUTTON_2_EXTI_IRQn EXTI15_10_IRQn
#define BUTTON_3_Pin GPIO_PIN_15
#define BUTTON_3_GPIO_Port GPIOB
#define BUTTON_3_EXTI_IRQn EXTI15_10_IRQn
#define LED_RED_Pin GPIO_PIN_6
#define LED_RED_GPIO_Port GPIOC
#define LED_BLUE_Pin GPIO_PIN_7
#define LED_BLUE_GPIO_Port GPIOC
#define LED_GREEN_Pin GPIO_PIN_8
#define LED_GREEN_GPIO_Port GPIOC
#define M1_FWD_Pin GPIO_PIN_8
#define M1_FWD_GPIO_Port GPIOA
#define M1_BACK_Pin GPIO_PIN_9
#define M1_BACK_GPIO_Port GPIOA
#define M2_FWD_Pin GPIO_PIN_10
#define M2_FWD_GPIO_Port GPIOA
#define M2_BACK_Pin GPIO_PIN_11
#define M2_BACK_GPIO_Port GPIOA
#define MOUSE_CS_Pin GPIO_PIN_15
#define MOUSE_CS_GPIO_Port GPIOA
#define BC_TX_Pin GPIO_PIN_10
#define BC_TX_GPIO_Port GPIOC
#define BC_RX_Pin GPIO_PIN_11
#define BC_RX_GPIO_Port GPIOC
#define MOUSE_PICO_Pin GPIO_PIN_12
#define MOUSE_PICO_GPIO_Port GPIOC
#define MOUSE_SCLK_Pin GPIO_PIN_3
#define MOUSE_SCLK_GPIO_Port GPIOB
#define MOUSE_POCI_Pin GPIO_PIN_4
#define MOUSE_POCI_GPIO_Port GPIOB
#define M2_ENC_A_Pin GPIO_PIN_6
#define M2_ENC_A_GPIO_Port GPIOB
#define M2_ENC_B_Pin GPIO_PIN_7
#define M2_ENC_B_GPIO_Port GPIOB
