vqxel/RezqMicromouse/AirLiteTalonFX/Core/Src/motor.cpp

/*
 * drive.c
 *
 *  Created on: Feb 5, 2025
 *      Author: mine215
 */

#include <motor.h>
#include "math.h"

Motor::Motor(GPIO_TypeDef *forwardPort, GPIO_TypeDef *backPort, uint16_t forwardPin, uint16_t backPin, volatile uint32_t *pwmCcr, TIM_HandleTypeDef *tim, uint32_t timChannel, bool inverted): forwardPort(forwardPort), backPort(backPort), forwardPin(forwardPin), backPin(backPin), pwmCcr(pwmCcr), tim(tim), timChannel(timChannel), inverted(inverted) {
	// idk what this init method is called but i'm doing it using c++ stuff!11!1
}

void Motor::init() {
  HAL_TIM_PWM_Start(tim, timChannel);
}

void Motor::setDriveDirection(DriveDirection direction) {
	GPIO_PinState forwardPinState;
	GPIO_PinState backwardPinState;

	switch (direction) {
	case FORWARD:
		forwardPinState = inverted ? GPIO_PIN_RESET : GPIO_PIN_SET;
		backwardPinState = inverted ? GPIO_PIN_SET : GPIO_PIN_RESET;
		break;
	case BACKWARD:
		forwardPinState = inverted ? GPIO_PIN_SET : GPIO_PIN_RESET;
		backwardPinState = inverted ? GPIO_PIN_RESET : GPIO_PIN_SET;
		break;
	case OFF:
		forwardPinState = GPIO_PIN_RESET;
		backwardPinState = GPIO_PIN_RESET;
		break;
	}

	HAL_GPIO_WritePin(forwardPort, forwardPin, forwardPinState);
	HAL_GPIO_WritePin(backPort, backPin, backwardPinState);
}

void Motor::setDriveDutyCycle(float dutyCycle) {
	// Clamp duty cycle to legal values
	if (dutyCycle > 0.72) {
		dutyCycle = 0.72;
	} else if (dutyCycle < 0) {
		dutyCycle = 0;
	}

	int ccr = PWM_ARR * dutyCycle;

	*pwmCcr = ccr;
}

void Motor::set(float dutyCycle) {
	if (dutyCycle == 0) {
		if (!brakeMode) setDriveDirection(OFF);
		else setDriveDirection(FORWARD);
	} else if (dutyCycle > 0) {
		setDriveDirection(FORWARD);
	} else if (dutyCycle < 0) {
		setDriveDirection(BACKWARD);
	}

	setDriveDutyCycle(abs(dutyCycle));
}
