vqxel/RezqMicromouse/AirLiteTalonFX/Core/Inc/encoders.h

/*
 * drive.h
 *
 *  Created on: Jan 30, 2025
 *      Author: mine215
 */

#pragma once

#include "constants.h"
#include "stm32f1xx_hal.h"
#include "main.h"
#include "deepstack.h"
#include <limits>

#define HISTORY 15

class Encoder {
private:
	TIM_HandleTypeDef *htim;

	bool inverted;

	float _conversionFactor;
	float lastPosMeters;
	float posMeters;
	uint32_t lastTick;

	DeepStack<float> pmHistory;
	DeepStack<uint32_t> tickHistory;

	float veloMeters;

	uint16_t rawPos;
	int64_t pos;
public:
	Encoder(TIM_HandleTypeDef *htim, bool inverted, float conversionFactor);

	void init();
	void callback(TIM_HandleTypeDef *htimCall, uint32_t cur);

	int64_t getPosition();

	float getLastPositionMeters();
	float getPositionMeters();

	float getVeloMeters();

	void tick();
};
