vqxel/RezqMicromouse/AirLiteTalonFX2/Core/Inc/pmw3389_srom.h

/* Copyright 2020 Christopher Courtney, aka Drashna Jael're  (@drashna) <drashna@live.com>
 * Copyright 2019 Sunjun Kim
 * Copyright 2020 Ploopy Corporation
 *
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
 * You should have received a copy of the GNU General Public License
 * along with this program.  If not, see <http://www.gnu.org/licenses/>.
 */
#ifndef INC_PMW3389_SROM_H_
#define INC_PMW3389_SROM_H_

#include "stdint.h"

#define FIRMWARE_LENGTH 4094

// Declarations only
extern const uint8_t firmware_signature[3];
extern const uint8_t firmware_data[FIRMWARE_LENGTH];

#endif
