vqxel/RezqMicromouse/(commit log)

2024-10-31 Path optimization. Some flood fill doesn't work anymore...
    [FloodFill.cpp, FloodFill.h, Main.cpp]
2024-11-02 Added path optimization. Optimizes for straight lines. Doesn't crash anymore on some maps altho theoretically it can fail if the map is winnable but too complex
    [FloodFill.cpp, Main.cpp]
2024-11-15 Updated motion profiles logic to support arbitrary initial and final velocities.
2024-11-28 Added CAD
    [bloo.kicad_pcb, bloo.kicad_sch, bloo.sch, rezq_rev2.kicad_pcb, rezq_rev2.kicad_sch]
2024-11-28 Routed more of the schematic, connected all ground planes
    [rezq_rev2.kicad_pcb]
2024-12-10 Prelim Final CAD
    [rezq_rev2.kicad_pcb]
2024-12-14 Final Layout
    [VXL - ALTFX.dxf, rezq_rev2.kicad_pcb]
2025-01-13 Updated VIA sizes
    [rezq_rev2.kicad_pcb]
2025-04-19 Version 3 PCB and some initial test code
    [rezq_rev2-B_Cu.gbl, rezq_rev2-B_Mask.gbs, rezq_rev2-B_Paste.gbp, rezq_rev2-B_Silkscreen.gbo, rezq_rev2-Edge_Cuts.gm1, rezq_rev2-F_Cu.gtl, rezq_rev2-F_Mask.gts, rezq_rev2-F_Paste.gtp]
2025-04-28 Sys transfer
    [rezq_rev3.kicad_pcb]
2025-05-22 Added v_comp (basics). Going to add ADC abstraction to easily switch between ADCs consistently since VSens & DSens are all on same ADC :(
2025-05-23 Sensors work even better now. Voltage conversion of v_meter works. Distance sensors seem to work but need to be tuned in lab. Encoders work but their CPR & ratios/conv to rotations per millimeter (me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
2025-11-25 Started CADding next gen mouse
    [mouse2_rev1.kicad_pcb, mouse2_rev1.kicad_sch, power_supply.kicad_sch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]
2025-11-29 Mouse 2 is ballin ish! got a bunch of layout done
    [mouse2_rev1.kicad_pcb, mouse2_rev1.kicad_sch]
2025-12-10 rev2 done !
    [mouse2_rev1.kicad_pcb, mouse2_rev1.kicad_sch]
2026-01-26 Micromouse is assembled and turns on! LEDs work as well. IOC is updated.
    [mouse2_rev1.kicad_pcb, mouse2_rev1.kicad_sch]
2026-01-27 Integrated Gyro
2026-01-27 rediscovered gimbal lock! yippeeee! gotta fix that stuff
    [main.c]
2026-03-31 Added proper quaternion IMU support for the gyro and accel. I don't want to fuse these normally and i wanna try a madgwick or kalman filter so i gotta research that and do this. cool stuff so far
2026-04-01 Added madgwick filtering. I understand the concept it's quite interesting. I haven't done the proof for it but I probably will tmrrw.
2026-04-02 Sensor fusion with madgwick for accel and gyro works for all 3 axes!
2026-04-10 Added EKF practice python code and imported ARM DSP library so I can start implementing EKF on the MM itself
2026-04-28 Mouse sensor working ! Major aura gain xd
2026-04-28 Added motor support. Untested.
2026-04-29 Added EKF integration for mouse sensor and stuff
2026-04-29 Updated mouse code to make it cleaner added auto calibrationg
2026-05-01 Added distance sensors and some calibration for the EKF
